YahyaSvm/EnderCNCs/Ender3CNC/fusion360 post processor.md

# Fusion 360 Klipperized post processor!
### Full credit to Zergie for this project. 

## Get it [here!](https://github.com/Zergie/mpcnc_post_processor/blob/main/MPCNC.cps)

You'll have to use this one if you are using Klipper as a controller for the CNC. 

## How to install: 
- Download the .cps file from the link above
- Open Fusion360
- Find and go to the "manufacture tab"
- Find and press "post process"
- Click the folder Icon (select post from the library)
- Click Import
- Find the downloaded .CPS file and press Select

It should now look like this


# info 
- Do NOT select "upload and run", this will auto start the cutting job
- Do not use G1->G0 rapids at first, get used to the machine first. This will make travel moves very fast. 
