YahyaSvm/EnderCNCs/Ender3CNC/Mods/2040_frame_mod/front_right_corner_2040.stl

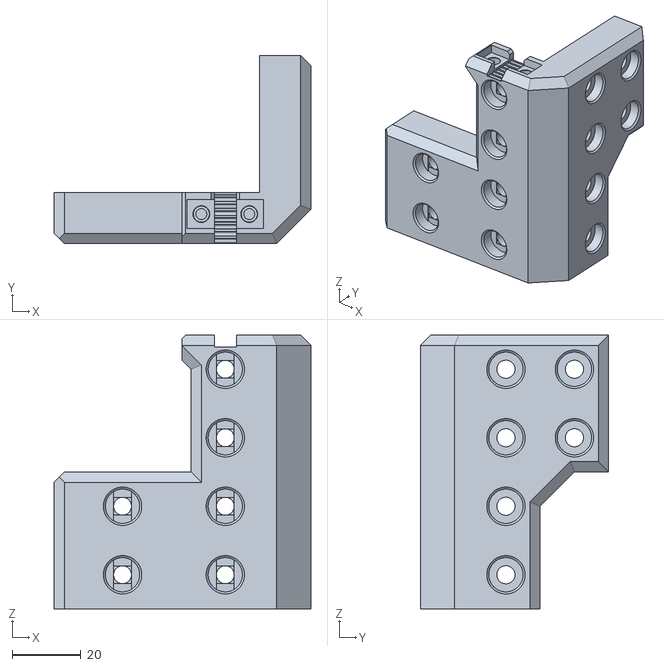
[picture p1: CAD file, 2025-12-09]
Ender3CNC/Mods/2040_frame_mod/front_right_corner_2040.stl
75.0 x 55.0 x 80.0
