YahyaSvm/EnderCNCs/Ender3CNC/Mods/2040_frame_mod/back_left_corner_2040.stl

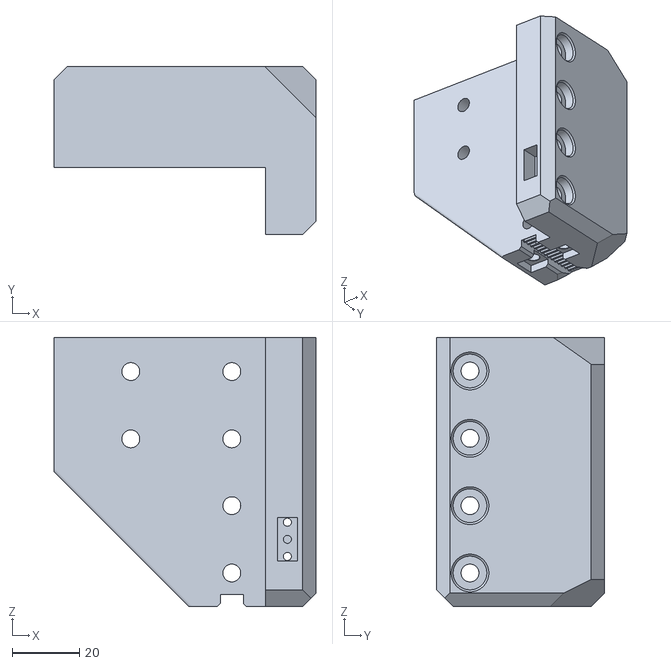
[picture p2: CAD file, 2025-12-09]
Ender3CNC/Mods/2040_frame_mod/back_left_corner_2040.stl
77.8 x 50.0 x 80.0
