YahyaSvm/EnderCNCs/(list of files, cad)

Other CAD files:
Ender3CNC/Mods/2040_frame_mod/front_left_corner_2040.stl
Ender3CNC/Mods/2040_frame_mod/back_right_corner_2040.stl
Ender3CNC/Mods/2040_frame_mod/corner_2040_mod_CAD.f3d
