YahyaSvm/EnderCNCs/Ender3CNC/User-Builds/readme.md

# Builds from other users! 
## Built one? post a picture or video in the Discord channel or DM Ravenkeeper on Printables to get a serial! 

### Beta tester build by Steve! Serial E3CNC.01


### E3CNC.02 by Shadowphyre!
c6e9ab00-61f4-485c-8042-61809af97d35

### E3CNC.03 by scalaw4g!


### E3CNC.04 by LostPhysicist!


### E3CNC.05 by Spoonie!


### E3CNC.06 by tim_loi!


### E3CNC.07 by slyngSh0t!


### E3CNC.08 by piro_o!
piro

### E3CNC.09 by __vz__!
need picture

### E3CNC.10 by Pickle!
pickle

### E3CNC.11 by Rian_ODonnell1337!
rian

### E3CNC.12 by Nulterm!
need picture

### E3CNC.13 by Laika!
laika

### E3CNC.14 by VEK!


### E3CNC.15 by superjasiek!


### E3CNC.16 by itsmosby!


### E3CNC.17 by TimToBeat!
tim
